Jvinuelapz/2WD_Mobile_Robot_Car/Workshop_4/Task_2_Reading_analogue_pins.ino

#include <MyLibrary.h>  

MyLibrary myLib;  

void setup() {
  Serial.begin(115200);  
  
  int result = myLib.addNumbers(350, 80);  

  Serial.print("The result of 350 + 80 is: ");
  Serial.println(result);
}

void loop() {
  
}
